qrti/epDcfWea/README.md

# **epDcfWea**

### **DCF-Clock and Weather-Station on Electronic Paper**

Docs, Schematic, Board, Source, 3D Print Frame

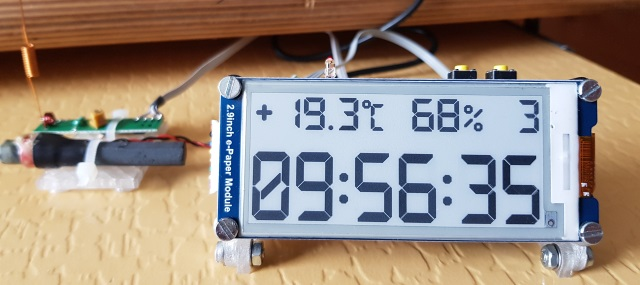
[picture p1: images/00_title.jpg]


----------

[qrt@qland.de](mailto:qrt@qland.de)
