qrti/epDcfWea/board/epDcfWea_board_dip40.png

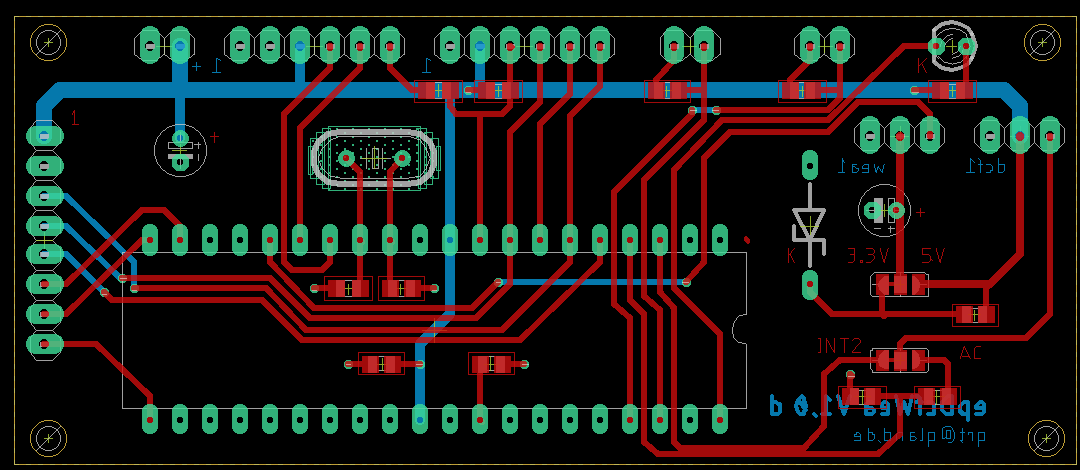
board/epDcfWea_board_dip40.png
