qrti/epDcfWea/board/epDcfWea_board_gnd_dip40.png

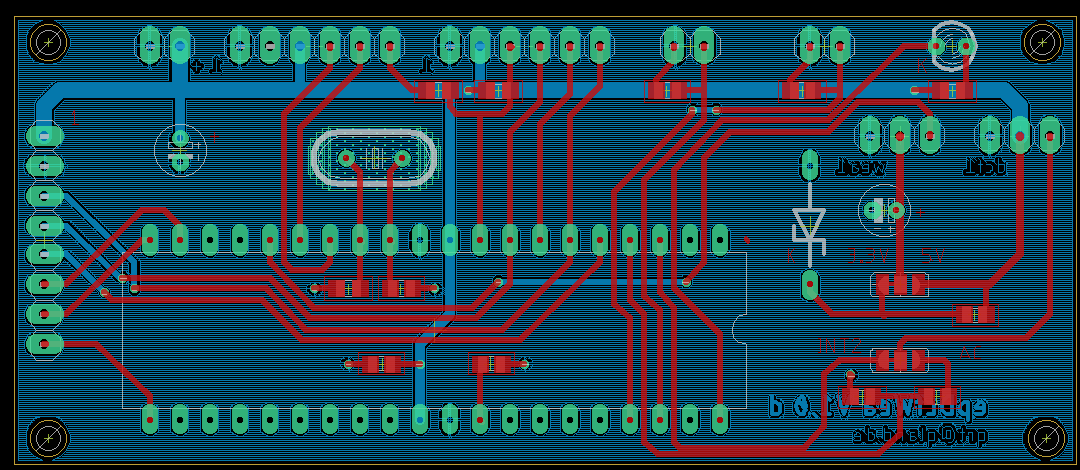
board/epDcfWea_board_gnd_dip40.png
