qrti/epDcfWea/board/epDcfWea_board_gnd_tqfp44.png

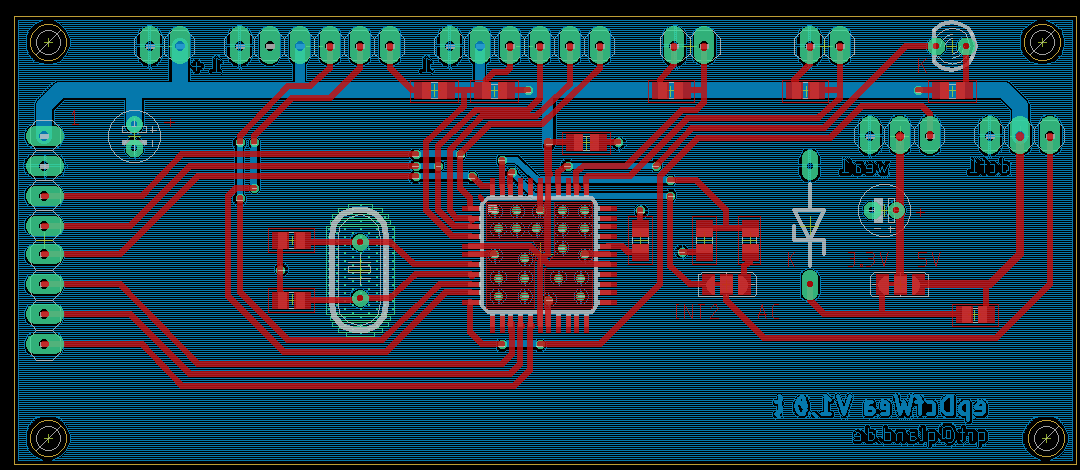
board/epDcfWea_board_gnd_tqfp44.png
