qrti/epDcfWea/board/epDcfWea_board_tqfp44.png

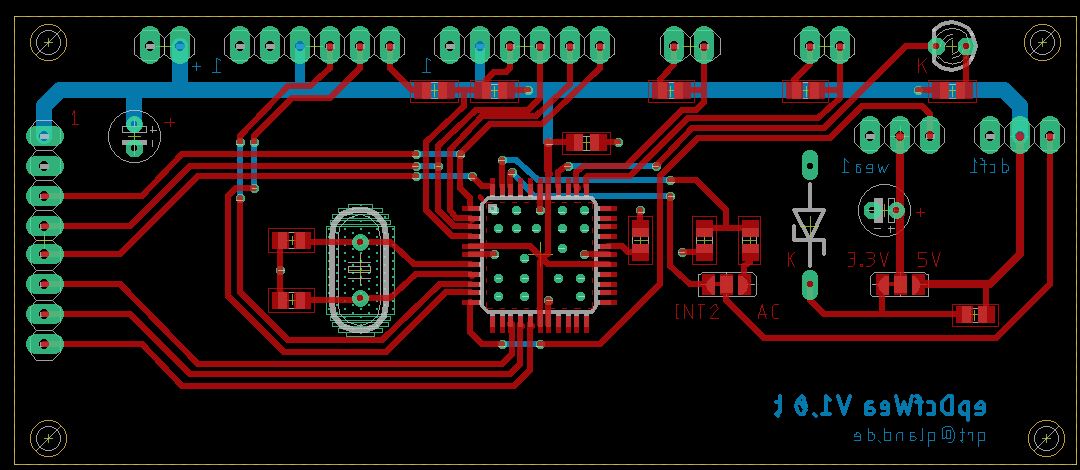
board/epDcfWea_board_tqfp44.png
