qrti/epDcfWea/docs/docs.jpg

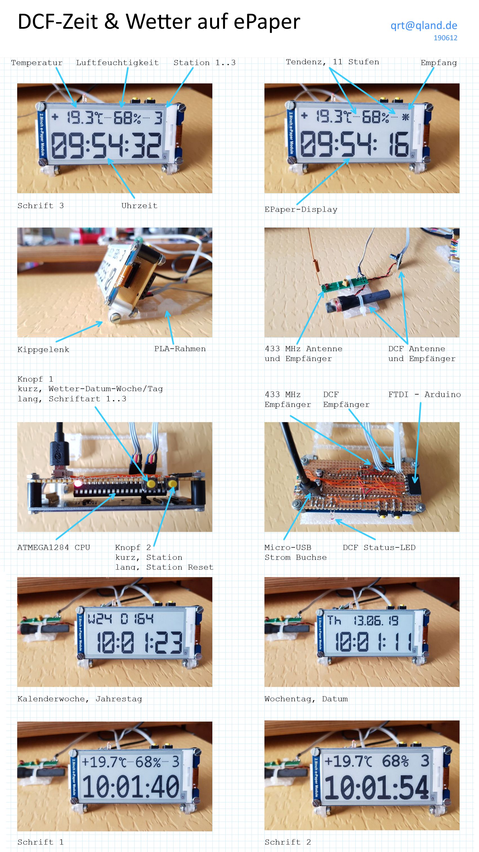
docs/docs.jpg
