qrti/epDcfWea/docs/wirewrap_top_bottom.jpg

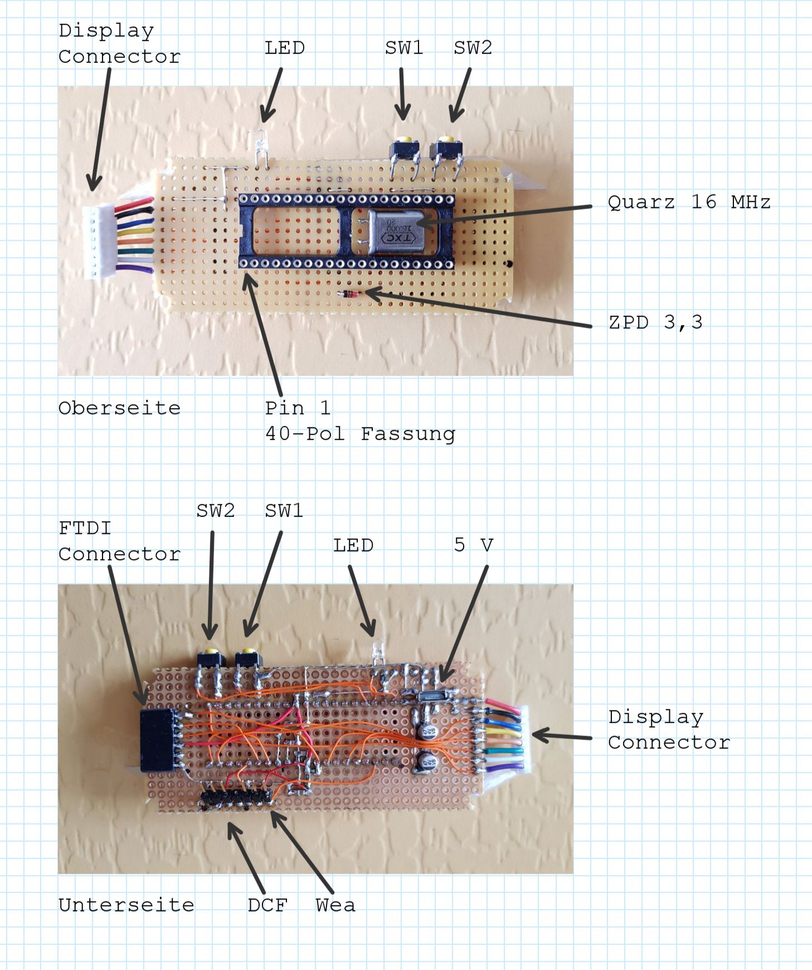
docs/wirewrap_top_bottom.jpg
