qrti/epDcfWea/images/01_total.jpg

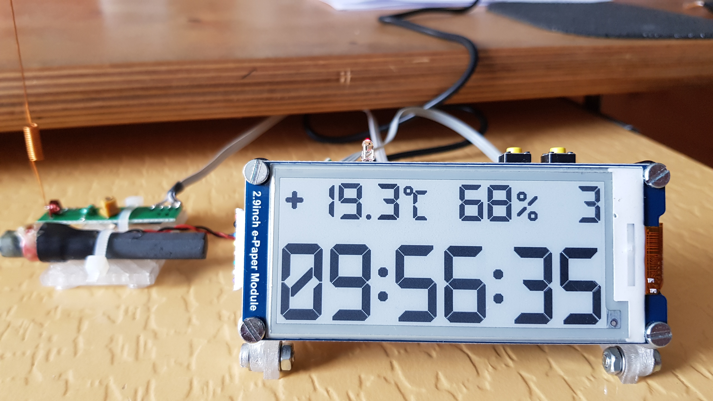
images/01_total.jpg
