qrti/epDcfWea/images/02_dcf_wea.jpg

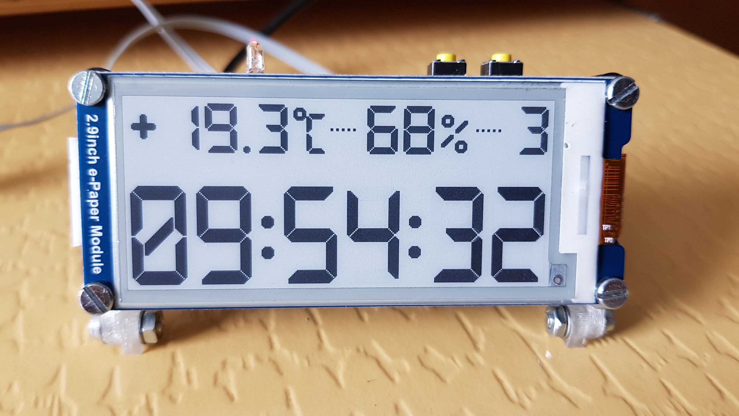
images/02_dcf_wea.jpg
