qrti/epDcfWea/images/03_dcf_wea_receive.jpg

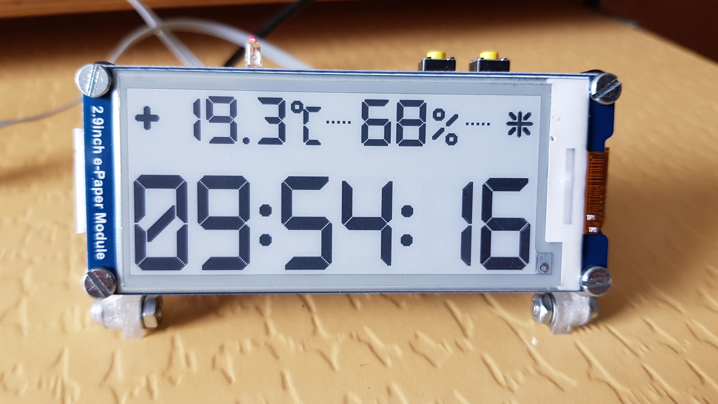
images/03_dcf_wea_receive.jpg
