qrti/epDcfWea/images/04_date.jpg

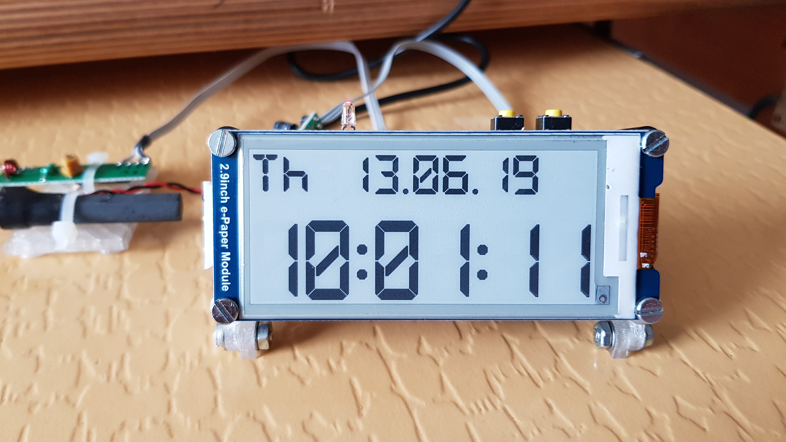
images/04_date.jpg
