qrti/epDcfWea/images/05_week_day.jpg

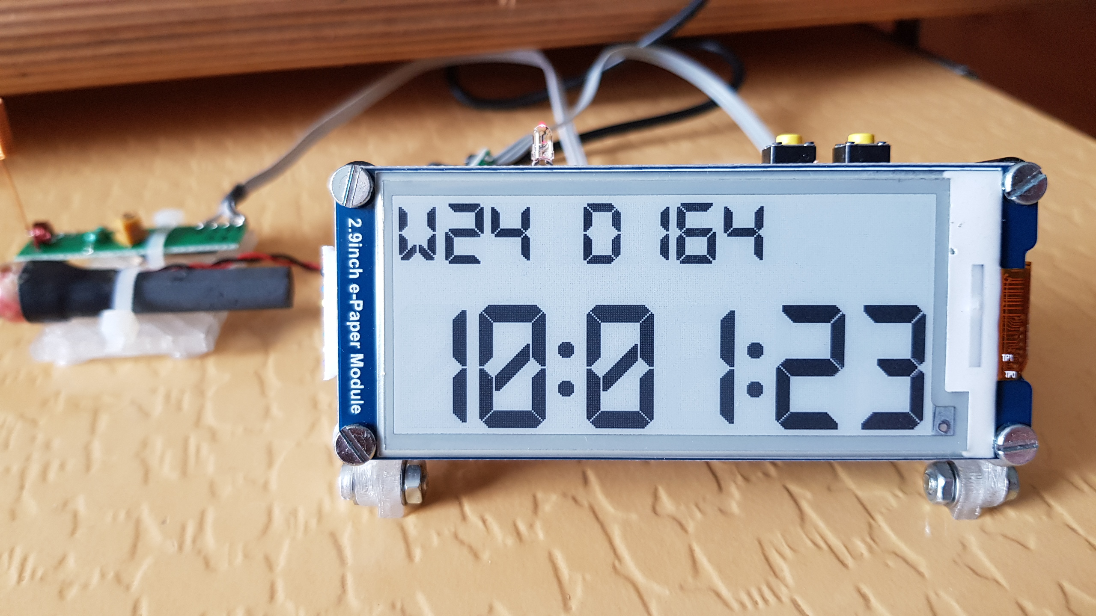
images/05_week_day.jpg
