qrti/epDcfWea/images/06_font_1.jpg

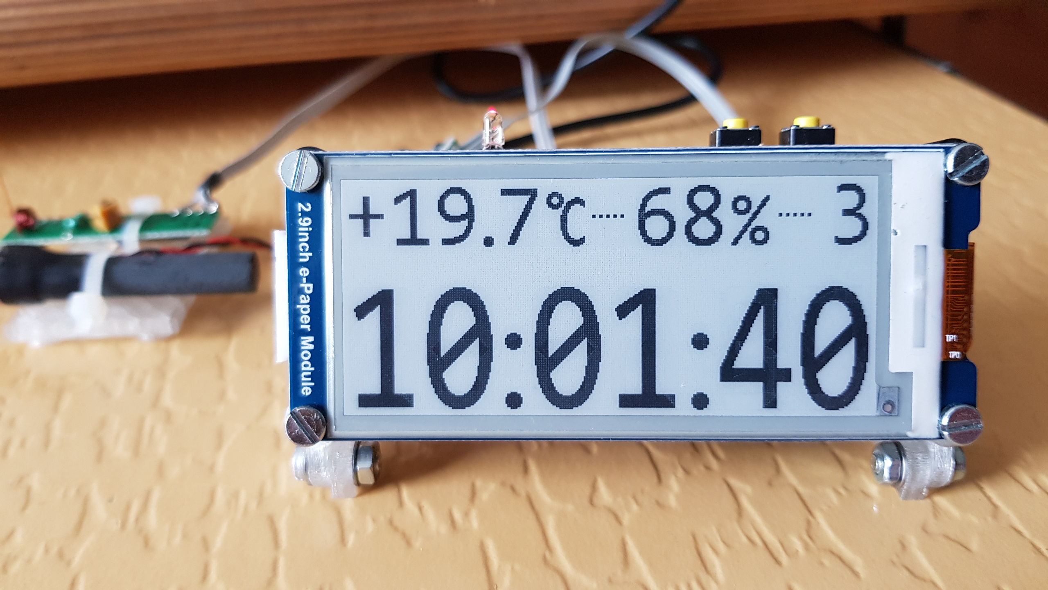
images/06_font_1.jpg
