qrti/epDcfWea/images/07_font_2.jpg

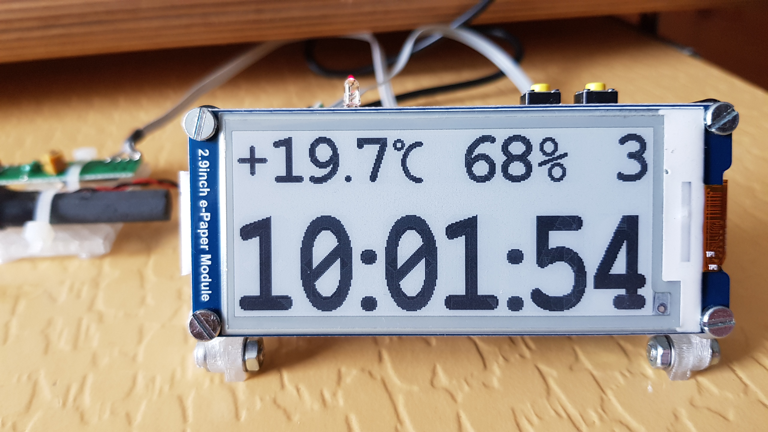
images/07_font_2.jpg
