qrti/epDcfWea/images/08_side.jpg

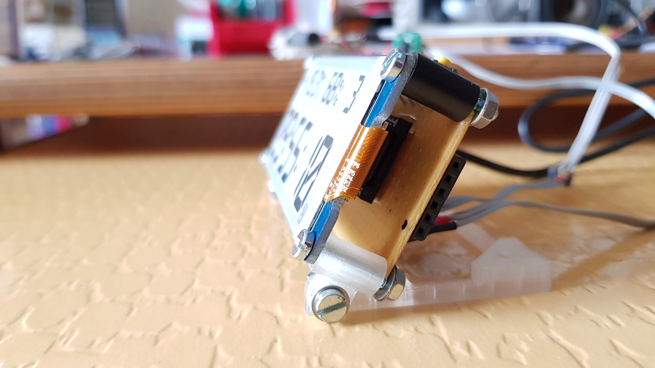
images/08_side.jpg
