qrti/epDcfWea/images/09_top.jpg

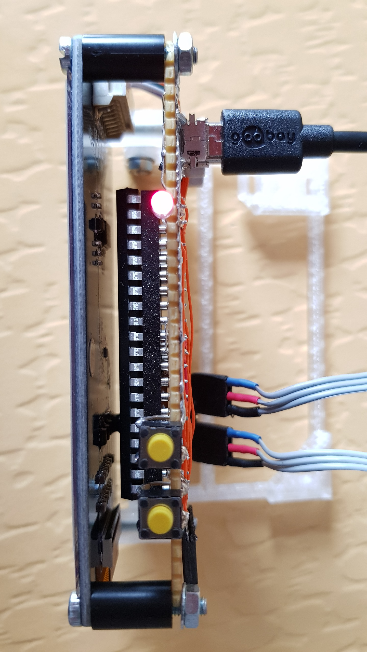
images/09_top.jpg
