qrti/epDcfWea/images/10_pcb_top.jpg

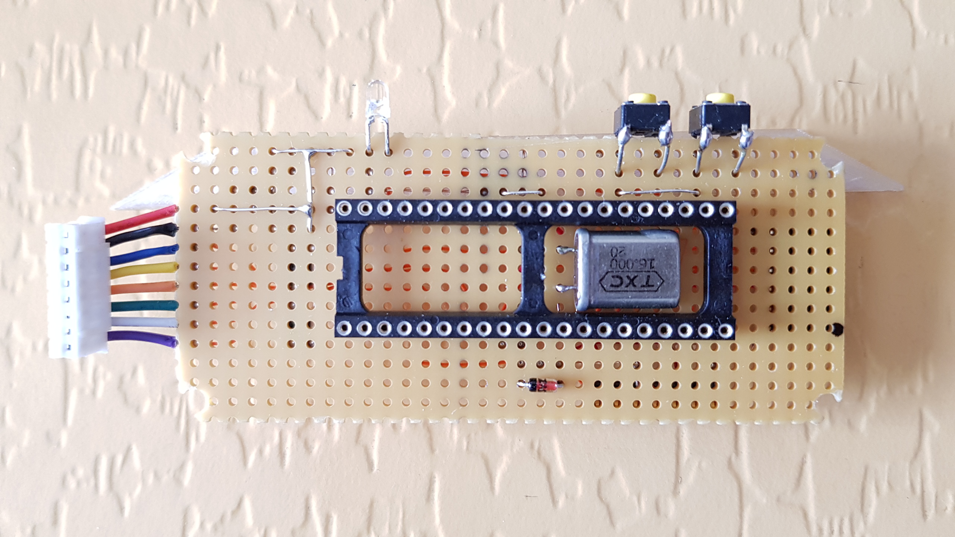
images/10_pcb_top.jpg
