qrti/epDcfWea/images/11_pcb_bottom.jpg

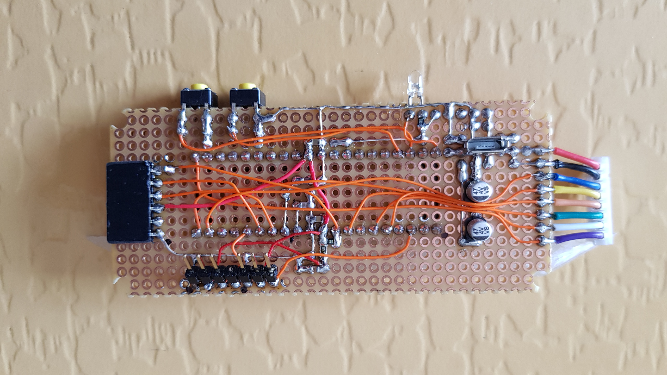
images/11_pcb_bottom.jpg
