qrti/epDcfWea/images/12_pcb_back.jpg

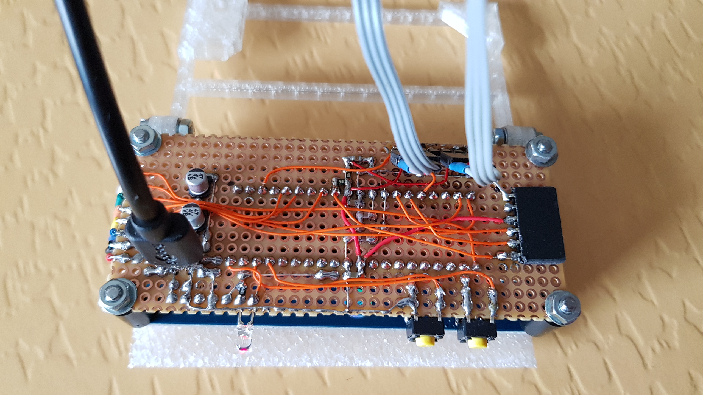
images/12_pcb_back.jpg
