qrti/epDcfWea/images/13_antennas.jpg

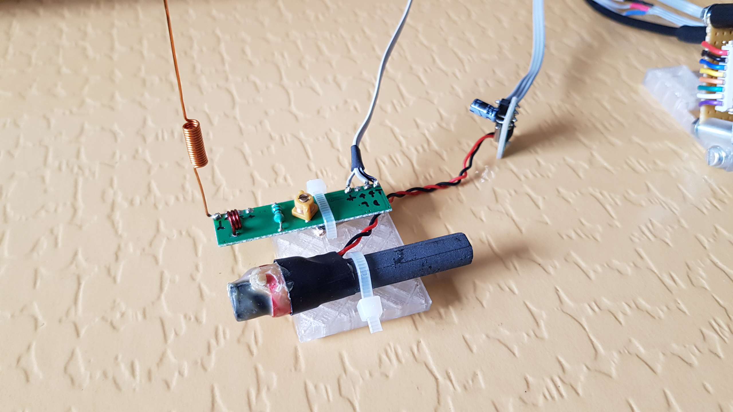
images/13_antennas.jpg
