qrti/epDcfWea/schematic/epDcfWea_schematic_dip40.png

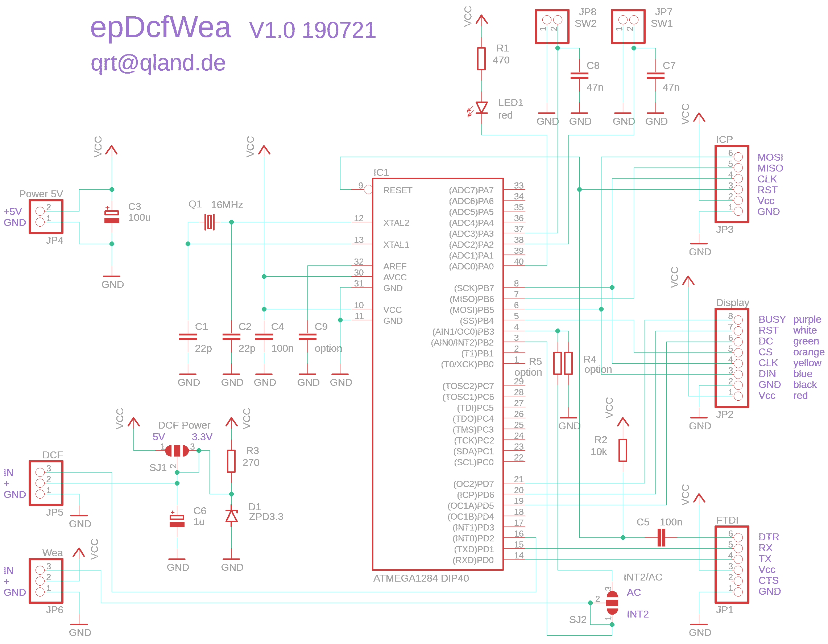
schematic/epDcfWea_schematic_dip40.png
