qrti/epDcfWea/schematic/epDcfWea_schematic_tqfp44.png

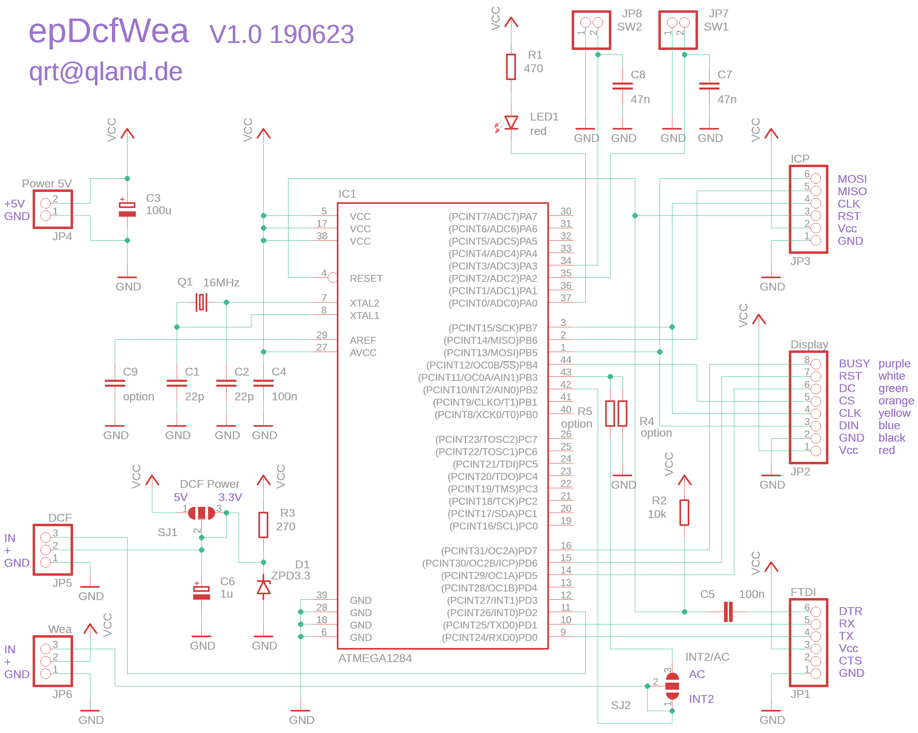
schematic/epDcfWea_schematic_tqfp44.png
