qrti/epDcfWea/print3D/parts.png

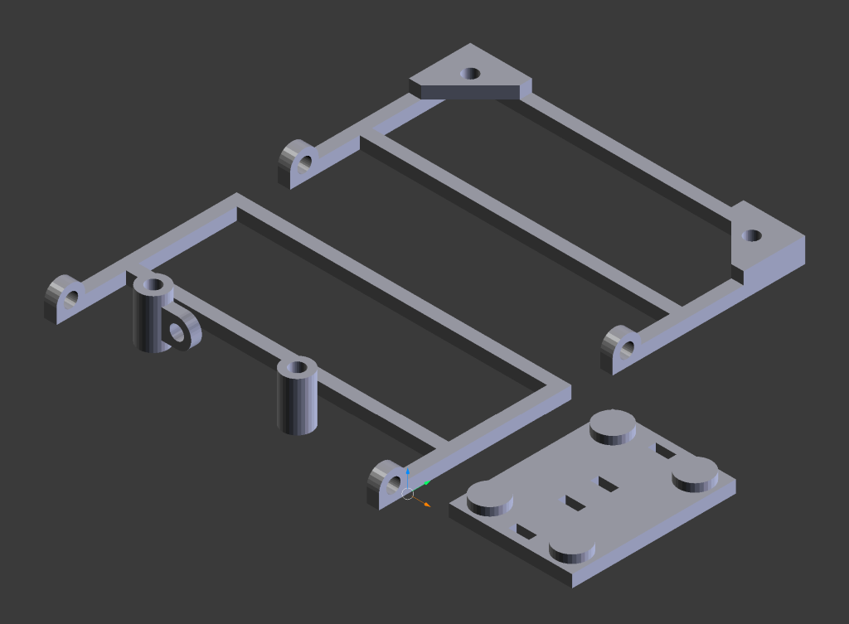
print3D/parts.png
