qrti/epDcfWea/print3D/distance.stl

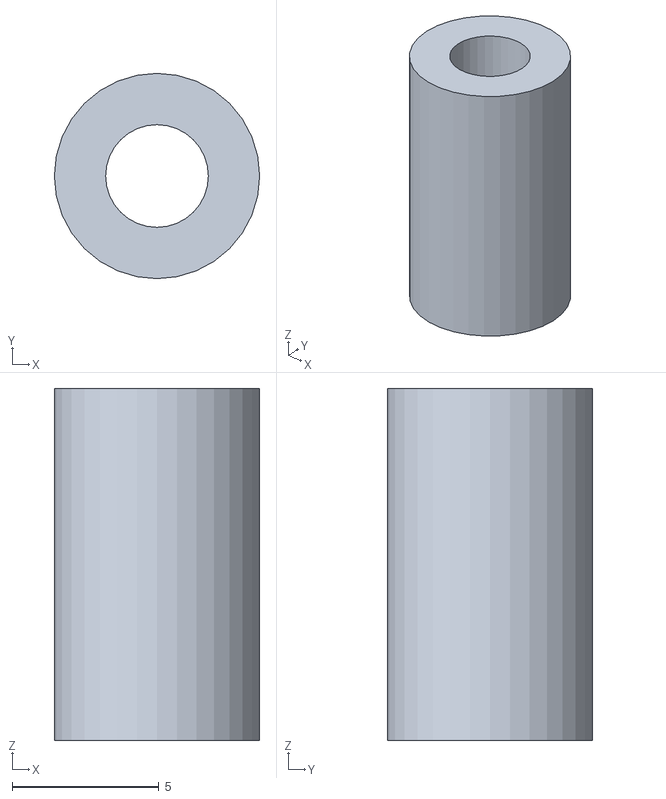
[picture p24: CAD file, 2019-07-24]
print3D/distance.stl
7.00 x 7.00 x 12.0
