qrti/epDcfWea/print3D/frame_mount.stl

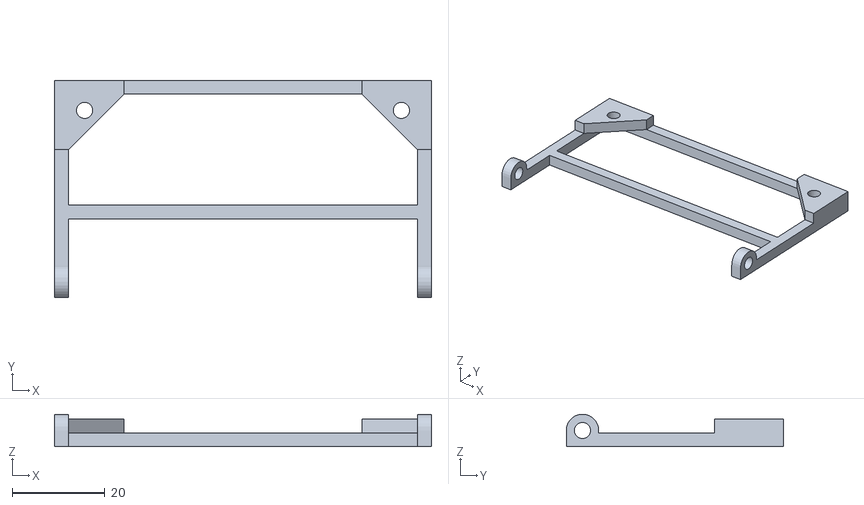
[picture p25: CAD file, 2019-07-24]
print3D/frame_mount.stl
81.5 x 47.0 x 7.00
