qrti/epDcfWea/print3D/plate.stl

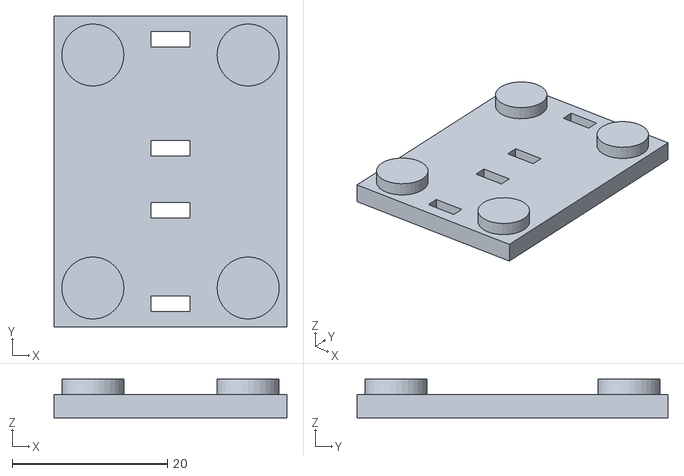
[picture p26: CAD file, 2019-07-24]
print3D/plate.stl
30.0 x 40.0 x 5.00
