qrti/epDcfWea/print3D/link.stl

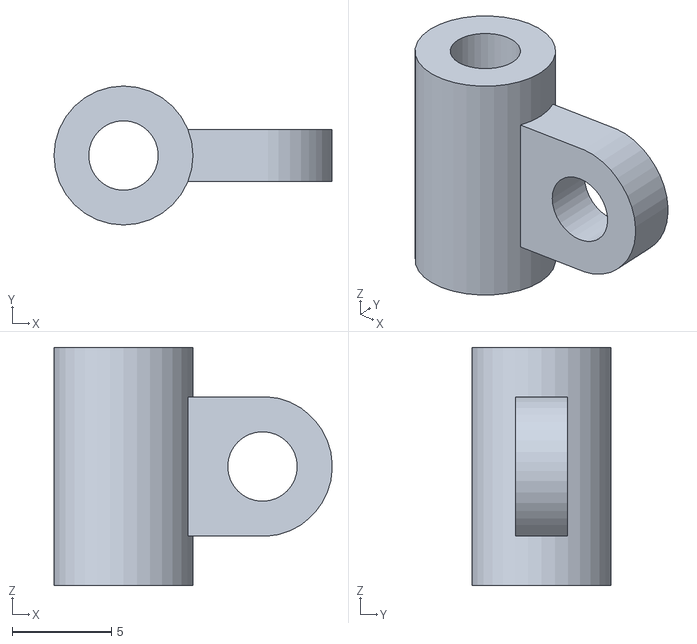
[picture p27: CAD file, 2019-07-24]
print3D/link.stl
14.0 x 7.00 x 12.0
